FHW-Appel/MicroMouse-car/README.md

# MicroMouse

Denken Sie daran, dass Sie keine großen Dateien wie Bilder oder PDFs ins Repository hochladen.
