FHW-Appel/MicroMouse-car/STL-Dateien/Motorhalterung.stl

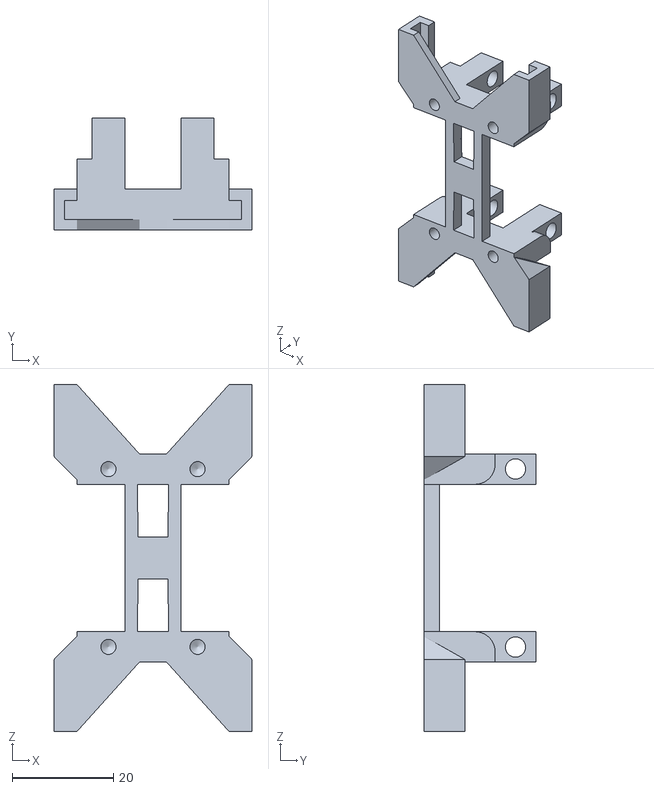
[picture p1: CAD file, 2025-06-27]
STL-Dateien/Motorhalterung.stl
39.0 x 22.0 x 68.5
