FHW-Appel/MicroMouse-car/STL-Dateien/Reifen_Grip.stl

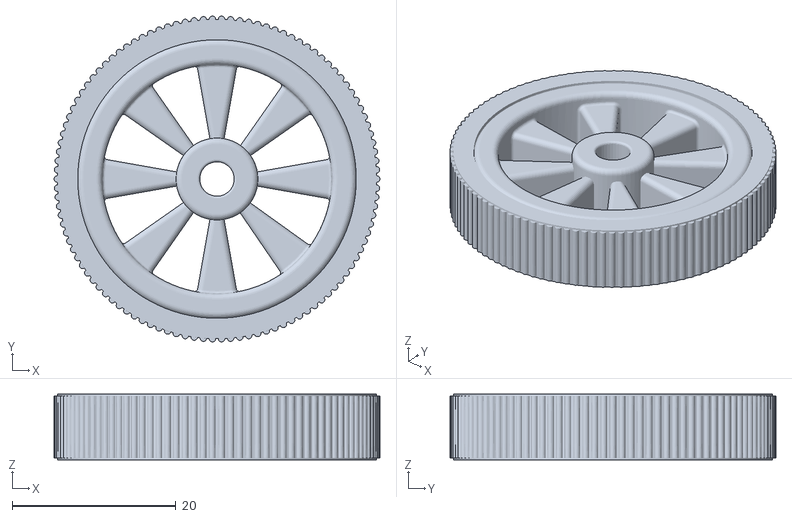
[picture p2: CAD file, 2025-06-27]
STL-Dateien/Reifen_Grip.stl
39.8 x 39.8 x 8.00
