FHW-Appel/MicroMouse-car/STL-Dateien/Schubplatte_Display.stl

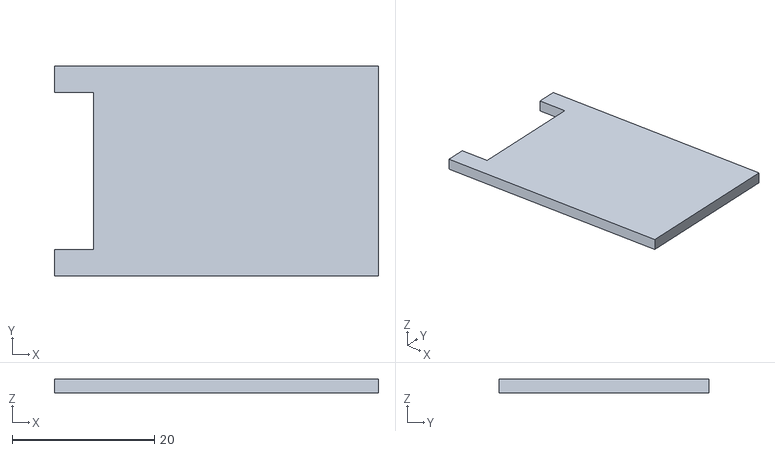
[picture p3: CAD file, 2025-06-27]
STL-Dateien/Schubplatte_Display.stl
45.5 x 29.5 x 2.00
