FHW-Appel/MicroMouse-car/STL-Dateien/Akkuhalterung.stl

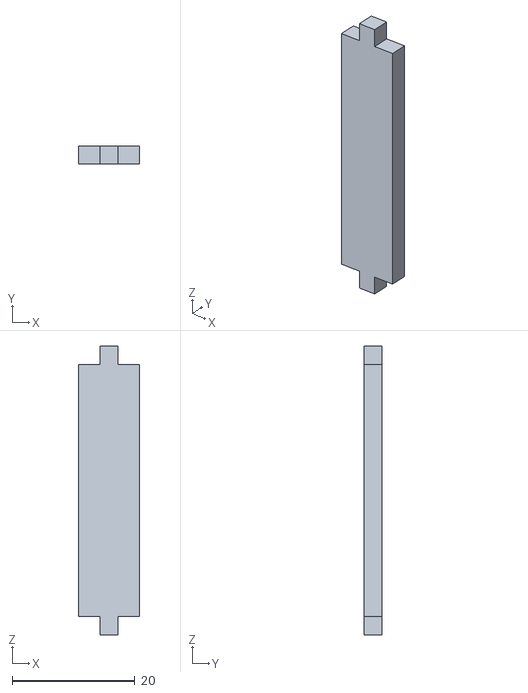
[picture p4: CAD file, 2025-06-27]
STL-Dateien/Akkuhalterung.stl
10.0 x 3.00 x 47.0
