FHW-Appel/MicroMouse-car/STL-Dateien/Sensorhalter_Schleifpunkt.stl

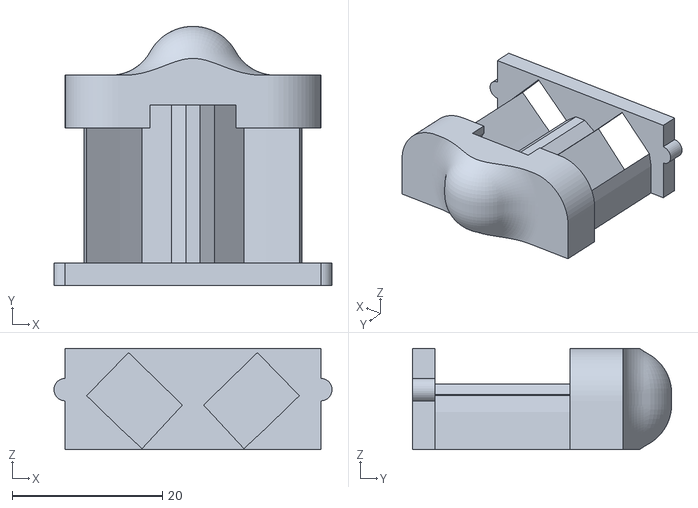
[picture p5: CAD file, 2025-06-27]
STL-Dateien/Sensorhalter_Schleifpunkt.stl
37.0 x 34.5 x 13.5
