FHW-Appel/MicroMouse-car/STL-Dateien/Deckel.stl

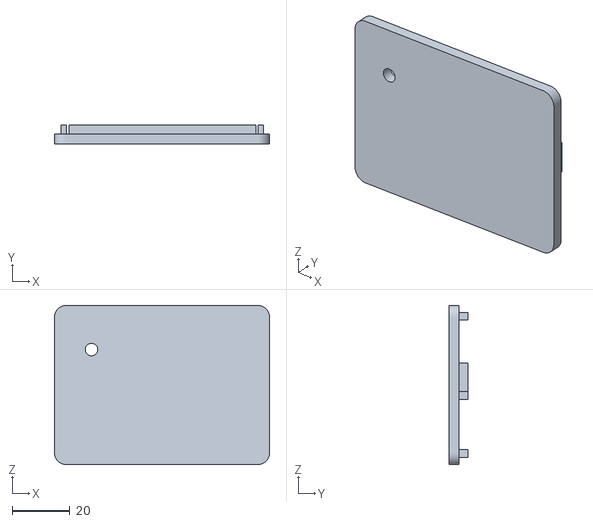
[picture p6: CAD file, 2025-06-27]
STL-Dateien/Deckel.stl
74.6 x 6.50 x 55.2
