FHW-Appel/MicroMouse-car/STL-Dateien/Kaese.stl

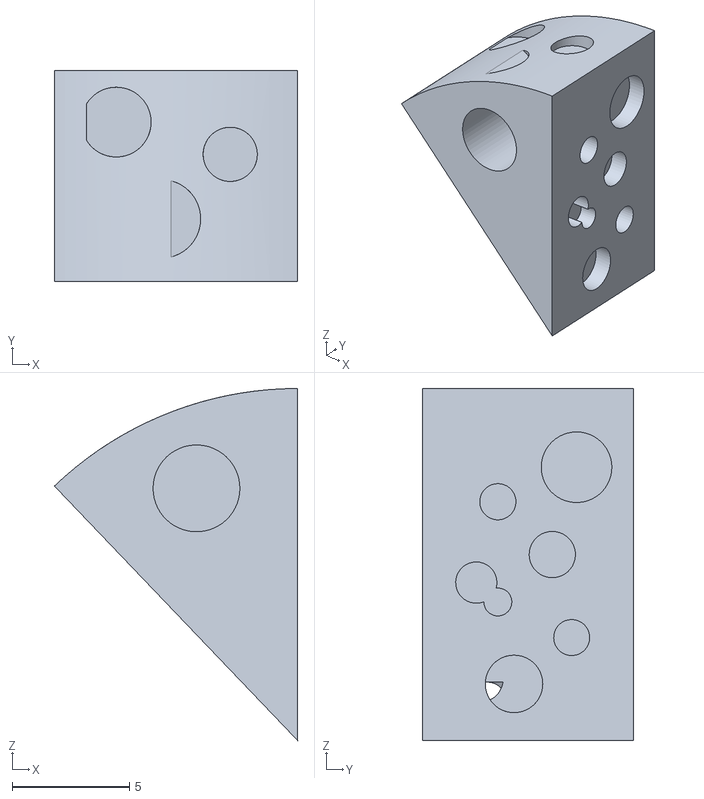
[picture p7: CAD file, 2025-06-27]
STL-Dateien/Kaese.stl
10.4 x 9.00 x 15.0
