FHW-Appel/MicroMouse-car/STL-Dateien/Displaygehäuse.stl

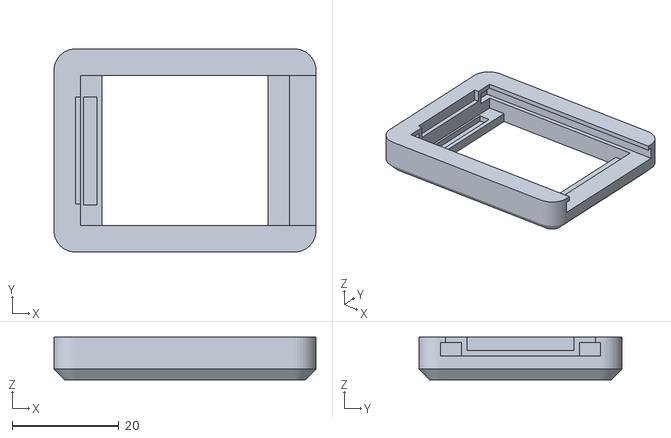
[picture p8: CAD file, 2025-06-27]
STL-Dateien/Displaygehäuse.stl
49.0 x 38.0 x 8.00
