FHW-Appel/MicroMouse-car/(list of files, cad)

Other CAD files:
Fusion-Konstruktionen/Akkuhalterung.f3d
Fusion-Konstruktionen/Deckel.f3d
Fusion-Konstruktionen/Displaygehäuse.f3d
Fusion-Konstruktionen/Kaese.f3d
Fusion-Konstruktionen/Micro Maus Motorhalterung.f3z
Fusion-Konstruktionen/Platinengehäuse.f3d
Fusion-Konstruktionen/Reifen_Grip.f3d
Fusion-Konstruktionen/SchubplatteDisplaygehäuse.f3d
Fusion-Konstruktionen/Sensorhalter_Schleifpunkt.f3d
