FHW-Appel/MicroMouse-car/(threads)

Thread 1 (2025-04-04):

Formfaktor ermitteln und festlegen

Nikoru112, 2025-04-04:
Nach den gängigen Richtlinien wird die gängige Größe festgelegt und mit den anderen Gruppen abgesprochen.

Nikoru112, 2025-05-09:
**Aktueller Stand Formfaktor 09.05.2025**
- Maximale **Breite** der Maus: **5cm** (Festgelegt, damit die Maus diagonal durch das Maze fahren kann)
- Maximale **Länge** der Maus: **7cm** (9cm(Breite Maze)- 7cm = 1cm Platz auf jeder Seite zum wenden)
(Max. Länge der Platine 6cm. Daher kann ggf. die Länge noch etwas eingekürzt werden.)
- Maximale **Höhe**: Hierzu gibt es **keine Vorgaben**.

Thread 2 (2025-04-04):

Fahrzeug

Nikoru112, 2025-04-04:
* Formfaktor ermitteln und festlegen
* Kompatibilität zum Shield
* Absprache Motor mit Shield Team
  * Aufnahme für Motoren entwickeln
* Lenktechnik festlegen
* Bumper
* Reifen
* Achsen und Lagen, wenn nicht im Motor enthalten
* Aufnahme Sensoren
* Akku definieren
* Akkuaufnahme
* Repository erstellen

* Design

### Projektstruktur - Fahrzeug:

### Haupt-Issues:
1. Formfaktor festlegen
#1
2. CAD u. Druck des Fahrzeugs
#16  (Inkl. aller Neben-Issues)
3. Design
#14

### Neben-Issues:

**Größe der Platine abstimmen**
#7
- CAD Platinenhalterung #17

**Kennwerte Motoren abstimmen**
#8
- CAD Aufnahme für Motoren designen #9

**Kennwerte der Sensoren abstimmen**
#10
-  CAD Halterungen: Positionierung der Sensoren #11

**Akku festlegen**
#12
- CAD Akku-Halterung #13

**Räder finden und beschaffen**
#15

**Repository erstellen**
#18

Closed 2025-06-27.

Thread 4 (2025-04-05):

Maze

FHW-Appel, 2025-04-05:
* Half size micro mouse Maße raussuchen und als Anforderungen zusammenschreiben
* Verbindungstechnik Schachbrettkästchen entwickeln und testen
* Verbindungstechnik Wände entwickeln und testen
* Wandmodule
* Blindstopfen entwickeln
* Wand zu Wand Verbindungen
* Repository erstellen

Thread 5 (2025-04-05):

Shield

FHW-Appel, 2025-04-05:
* Recherche notwendigen Sensoren
* Recherche notwendigen Motoren
* Visualisierung Gerätezustand
* Debugschnittstelle
* Schnittstelle uC Platine
* Microcontrollerplatine (uC) festlegen
  * nicht älter als drei Jahre
  * STM32L oder U

* Kompatible zum uC, Spannungsversorgung, Montage
* Hot-Swap

Thread 6 (2025-04-05):

Programmierung Abstraktionslayer

FHW-Appel, 2025-04-05:
* Absprache mit Shield Team über Schnittstellen
  * Sensoren
  * Motoren
  * (Speicher)
  * LEDs, etc..
* Implementierung einer Debug-Schnittstelle (UART)
* Abtraktions Layer erstellen
* Support Layer Erstellen
* Repository erstellen
* Test-Cases erstellen
* Tests Automatisieren

Thread 10 (2025-04-06):

Dimensionen der Sensoren erfragen

MiBeFe, 2025-04-06:
**Beschreibung:**
Die Größe und Anzahl der Sensoren wird durch die Shield-Gruppe festgelegt.
Wir überprüfen die Kompatibilität mit der der Gesamtgröße/ des Formfaktors des Fahrzeugs.

**Akzeptanzkriterien:**
- Daten von der Shield-Gruppe erhalten(Größe u. Anzahl Sensoren)
- Sensoren passen in die Maus.
- Klärung der Sensorlage in der Maus

LuiNi31, 2025-05-14:
Sensoren wurden bestellt und sind stand 14.05.2025 angekommen. Die Sensoren entsprechen der gewünschten Größe und sind dementsprechend kompatibel mit der Maus.

FHW-Appel, 2025-05-16:
Warum liegt dieses Issue noch in der Spalte _"In progress"_? Bitte nach _"Review"_ verschieben.

Nikoru112, 2025-05-16:
**To do erledigt Stand 16.05.2025**

Akzeptanzkriterien:
**"Daten von der Shield-Gruppe erhalten(Größe u. Anzahl Sensoren)"**
Sensoren sind , wie oben am 14.05. dokumentiert, bei uns eingetroffen, somit liegt die Größe und Anzahl vor.
"In der Maus werden 2 Sensoren vorne und zwei hinten verbaut.!
**"Sensoren passen in die Maus."**
Mit den Maßen von ca. 10x10x25mm passen die Sensoren in die Maus.
"Klärung der Sensorlage in der Maus"
Jeweils im 45Grad- Winkel nach links und rechts in Fahrtrichtung der Maus. Hinten identisch.

Da alle Akzeptanzkriterien erfüllt wurden, kann dieses Issue geschlossen werden.

Closed 2025-05-17.

Thread 11 (2025-04-06):

Positionierung der Sensoren + passende Aufnahme designen (soll nach möglichkeit zum Thema Maus beitragen)

MiBeFe, 2025-04-06:
Vermutlich einer der folgenden Typen:
- Sonar sensors
- IR distance measuring sensors — sharp IR
- Time of Flight(ToF) sensors
ausgewählt nach:
- Reaktionszeit
- Genauigkeit
- Reichweite
- Größe

Positionierung legt am Ende das Sichtfeld der Maus fest. Vermutlich mindestens 4 Sensoren für gute Navigation benötigt.

Nikoru112, 2025-05-09:
**Aktueller Stand Sensoren Positionierung (09.05.2025)**
- Die Sensoren werden in der zweimotorigen Maus im vorderen Teil, der nicht durch die Motoren(hinten) belegt ist untergebraucht.
- Die  Abstandssensoren werden auf einer Trägerplatte in der vorderen Teil der Micro-Maus geschoben.
- An dieser Trägerplatte befindet sich zusätzlich der "Schleifpunkt".

FHW-Appel, 2025-05-16:
Bitte unter Code auch die f3d Dateien ablegen.

Nikoru112, 2025-05-16:
**Aktueller Stand Sensorhalterung (16.05.2025)**
- Die erste Version der Sensorhalterung wurde erstellt. Sie trägt 2 Sensoren und lässt sich in den vorderen und hinteren Teil der Micro Maus schieben.
- An der Sensorhalterung befindet sich zusätzlich der Schleifpunkt der Maus, damit diese auf 2 rädern fahren kann.
- f3d-Datei der Sensorhalterung wurde hochgeladen.

Thread 12 (2025-04-06):

Mit Shield-Gruppe den Akku Dimensionieren

MiBeFe, 2025-04-06:
**Beschreibung**
Die Größe der Platine wird zusammen mit der Shield-Gruppe fest gelegt. Hierbei wird zusammen eine Akku-Größe gefunden.
Wir überprüfen die Kompatibilität mit der der Gesamtgröße/ des Formfaktors des Fahrzeugs.
Auf diese Basis der Akkugröße wird das Fahrzeug geplant.

Die Spannung wird durch die Shield-Gruppe festgelegt.

**Akzeptanzkriterien:**
- Daten von der Shieldgruppe erhalten
- Akku ist kleiner als die Außenmaße des Fahrzeugs

Vorläufiges Ergebnis:
https://www.conrad.de/de/p/renata-icp501233pa-spezial-akku-prismatisch-kabel-lipo-3-7-v-175-mah-252025.html
Spannung: 3.7V | Kapazität (mAh, Ah): 175mAh oder
https://www.conrad.de/de/p/renata-icp50123ps-03-spezial-akku-prismatisch-kabel-lipo-3-7-v-130-mah-252021.html
Spannung: 3.7V | Kapazität (mAh, Ah): 130mAh

- Erstmal werden wir den Akku mit der höheren Kapazität (aber auch leicht größeren Maßen) ausprobieren.
- Durch Reihenschaltung von zwei besagten Akkus erhalten wir: Spannung 7,4V | Kapazität 175mAh.
- Maße des Akkus passen zwischen die Motoren.
- Spannungsvorgaben des Shieldteams sind erfüllt.
- Preislich im Rahmen

MiBeFe, 2025-05-11:
Auswahl eines Akkus vorläufig Abgeschlossen. Der 175mAh Akku erfüllt unsere Ansprüche am Besten:
- Durch Reihenschaltung kommen wir auf die Vorgabe des Shield-Teams.
- Die minimal größeren Maße sind in Anbetracht der verbesserten Kapazität akzeptabel.
Es folgen eventuell noch Änderung aufgrund von Anpassungen an der Form des Fahrzeugs bzw. der Platine.
Bestellung der Akkus ist angefragt.

Closed 2025-05-11.

Thread 13 (2025-04-06):

CAD Akku-Halterung

MiBeFe, 2025-04-06:
Die Maus verfügt über einen geeigneten Ort zur Unterbringung der Akkus.

**Akzeptanzkriterien**
- Die Akkus passen in die Maus.
- Akkus sind bei bedarf entnehmbar.
- Akkus haben einen fest definierten Platz.
- Der Schwerpunkt der Maus wurde beachtet

Nikoru112, 2025-05-03:
**Erstellung von Akkus in Fusion**
Die Akkus wurde in Fusion den Abmessungen entsprechenden nachgebaut
2 Verschiedene Akkuversionen haben wir jeweils 2x ausgedruckt.

LuiNi31, 2025-05-14:
2 Akkus (Renata ICP581323PA Spezial-Akku Prismatisch Kabel LiPo 3.7 V 140 mAh) wurden bestellt und sind seit dem 14.05.2025 Vorort. Die Akkus entsprechen unseren Vorstellungen und sind größentechnisch kompatibel mit der Maus. Es werden stand jetzt 2 Akkus in Reihe geschaltet. Die Akkus sind kompatibel mit den 1,7V Motoren.

Nikoru112, 2025-05-16:
**Aktueller Status 16.05.2025 Akkus**

In der Aktuellen Micro Maus Version werden die Akkus in der Maus zwischen den Motoren untergebracht.
Aktuell ist in Klärung, ob 2 oder 4 Akkus verwendet werden.

MiBeFe, 2025-06-06:
Wir haben uns nochmal für andere Akkus entschieden, da diese mehr Kapazität mitbringen und nahezu perfekt in die vorgesehene Aussparung passen. Es handelt sich um: 3.7V 200mAh Akku 502025 Lithium-Polymer-Ionen-Lithium-Ionen-Li-Po-Akku mit 2P-PH-Anschluss mit 2.0 mm Rastermaß bei https://www.amazon.de/dp/B0CSS49XFG?ref=ppx_yo2ov_dt_b_fed_asin_title.
Zwei Stück sind bestellt worden und seit dem 06.06.25 vor Ort und montiert.

MiBeFe, 2025-06-27:
Die Akkuhalterung ist nun endgültig fertiggestellt und schließt die Aussparung zwischen den Motoren vollständig ab. Dadurch sind die Akkus stabil sowie sicher verankert und dennoch jederzeit einfach entnehmbar. Die Halterung selbst wird zwischen den Sensoraufnahmen eingeschoben. Um die Akkus zu entnehmen, muss lediglich eine Sensorhalterung gelöst werden.

Closed 2025-06-27.

Thread 14 (2025-04-06):

CAD: Design (Mausartig) umsetzen

MiBeFe, 2025-04-06:
**Beschreibung:**
Design des Fahrzeug an die Ähnlichkeit einer Maus.
Ggf. Graues kantiges design wie ein Cybertruck im Maus design.

**Akzeptanzkriterien:**
- Eine 3. Person erkennt, das es sich bei dem Fahrzeug um eine Maus handelt.
- Weiteres Erfolgt je nach verfügbarer Zeit.

**Möglichkeiten:**
- Fell
- kleine Ohren
- Augen mit Sensoren oder LED's nachahmen
- Schwanz (gehört wenn angehängt womöglich nicht zum Fahrzeug selbst und dürfte somit Kontakt zu Wänden haben)
- Räder genauer Felgen mit Füßchen bekleben/bemalen (wenn seitlich genug Platz übrig)
- kleiner Lautsprecher für mausartige Geräusche oder so

Closed 2025-06-27.

Thread 15 (2025-04-06):

Räder finden u. beschaffen (Rädermaße u. Bereifung)

MiBeFe, 2025-04-06:
**Beschreibung:**

Findung der passenden Räder für die Maus. Dabei müssen diese zum Motor passen und dem in #8 ermittelten Motor zusammenpassen.

Abstand zum Boden und Ziel-Untergrund muss beachtet werden.
Haftung sollte möglichst groß sein ohne Lenken oder Motorleistung zu beeinträchtigen.

Berechnung der Geschwindigkeit in Verbindung mit den Ausgewählten Motoren, sodass die Maus nicht zu langsam und nicht zu schnell ist.

**Akzeptanzkriterien:**
- Die Maus hat Räder.
- Die Räder können die Maus bewegen.
- Die Räder passen zum Motor
  - Ein Durchdrehen der Reifen auf der Achse kann bei bekannter maximaler Beschleunigung ausgeschlossen werden.
- Das Fahrzeug hat keine Bauteile im Bereich der Räder(Ggf. in Fusion anpassen)
- Räder drehen nicht durch.
  - Der Traktionskoeffizient ist bekannt.
  - Aus dem Traktionskoeffizient kann die maximale Beschleunigung errechnet werden.

ChrErn18, 2025-04-23:
## Entscheidung zur Rädern: Kauf statt Eigenkonstruktion

### Hintergrund:
Ursprünglich war vorgesehen, die Reifen für das Micro-Kart selbst zu entwerfen und im 3D-Druckverfahren herzustellen. Diese Strategie wurde auf Basis folgender Überlegungen verworfen:

- Zeit- und Ressourcenaufwand für Konstruktion, Testdrucke und Materialauswahl wäre aktuell zu hoch (die frühzeitige Erstellung eines Prototyps wird priorisiert)
- Es gibt auf dem Markt passende Reifenlösungen, die unsere Anforderungen bereits erfüllen könnten

### Neue Vorgehensweise:
- Recherche nach **geeigneten käuflich zu erwerbenden Reifen**, die folgende Kriterien erfüllen:
  - **Sehr hoher Grip**
  - **Breite unter 5 mm**
  - **Kompatibilität mit dem Motor** (siehe Issue #8)
  - Passend für unseren Ziel-Untergrund
  - Erlauben ausreichenden Bodenabstand
- **Beschaffung der gewählten Reifen**

### Zukünftige Option:
Sollten im weiteren Projektverlauf Kapazitäten frei werden, bleibt die Option offen, ein eigenes Reifenmodell zu konstruieren. Diese Alternative wird aktuell **nicht weiterverfolgt**, soll aber bei Bedarf reaktiviert werden können.

ChrErn18, 2025-04-25:
## Entscheidung zurück zur Eigenkonstruktion

### Hintergrund:
Nach längerer Recherche wurden leider keine passenden Reifen/ Räder gefunden, die allen Anforderungen entsprechen (Breite >5mm, Durchmesser > 30mm, Kompatibilität 4mm Achse).

### Neue Vorgehensweise:
- Reifen selbst in einer CAD Software erstellen und mit dem 3D-Drucker ausdrucken
- es sollen weiterhin die folgenden Kriterien erfüllt werden:
  - **Sehr hoher Grip**
  - **Breite unter 5 mm**
  - **Durchmesser unter 30mm**
  - **Kompatibel mit 4mm Wellen des Motors**
  - **Kompatibilität mit dem Motor** (siehe Issue #8)
  - Passend für unseren Ziel-Untergrund
  - Erlauben ausreichenden Bodenabstand

FHW-Appel, 2025-04-30:
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

Ich habe Filament TPU 95A beschafft:
https://www.3dmensionals.de/ultimaker-tpu-95a-premium-filament-4610#attr=42626,42625,42637,42624,42619,42620,42623,42622,42631,42632,42636
Mit diesem Filament können Sie Gummiartige Reifen drucken.

ChrErn18, 2025-04-30:
> [@ChrErn18](https://github.com/ChrErn18) Ich habe Filament TPU 95A beschafft: https://www.3dmensionals.de/ultimaker-tpu-95a-premium-filament-4610#attr=42626,42625,42637,42624,42619,42620,42623,42622,42631,42632,42636 Mit diesem Filament können Sie Gummiartige Reifen drucken.

Vielen Dank, das hilft uns sehr weiter!

ChrErn18, 2025-05-09:
## Reifenentwicklung

Die den Kriterien entsprechenden Reifen wurden in Fusion 360 modelliert und anschließend mittels 3D-Druck gefertigt. Das gedruckte Modell wurde begutachtet und basierend auf den Beobachtungen angepasst. Aktuell befinden wir uns bei der dritten Version des Reifens, welche ebenfalls ausgedruckt wurde und als Grundlage für die weitere Bearbeitung dient.

LuiNi31, 2025-05-14:
Die Reifen mit dem Durchmesser von 31mm entsprach nicht unseren gewünschten Vorgaben, daher haben wir die Reifen auf einen Durchmesser von 40mm vergrößert und diese passten sehr gut. Nur waren die Reifen, wenn man von oben guckt nicht plan mit dem Motor. Da wir nur zum Boden hin einen Überstand brauchen, verkleinern wir die Reifen auf 39 mm. Als nächstes drucken wir die Reifen mit einem Durchmesser von 39 und wenn der zufriedenstellend ist, werden wir die finalen Reifen mit zwei verschiedenen Filamenten drucken. Dementsprechend bestehen die Reifen im finalen Zustand zu 95% aus PLA und 5% aus TPU. Die Riffelung der Reifen, also der Teil der Bodenkontakt hat besteht aus TPU.

ChrErn18, 2025-05-14:
Zur Bestimmung des Traktionskoeffizienten und der maximalen Beschleunigung, ist in der kommenden Stunde ein Versuch geplant. Voraussetzung ist, das wir bis dahin einen Reife drucken, der mit zwei Filamenten gedruckt wurde (PLA und TPU).
Genauere Beschreibung des Testaufbaus, der Durchführung und der entsprechenden Ergebnisse flogen, sobald der Versuch durchgeführt wird.

FHW-Appel, 2025-05-16:
Bitte Ihren aktuellen Druck als f3d Dateien ablegen und in diesem Issue den aktuellen Entwicklungsstand dokumentieren.

ChrErn18, 2025-05-16:
## Aktueller Entwicklungsstand (16.05.2025)

Es wurde ein angepasstes Modell des Reifens erstellt, welches aus zwei Bestandteilen besteht. Einer Felge aus PLA und einem Reifen mit Profil aus TPU. Es war geplant die beiden Komponenten mit den beiden unterschiedlichen Filamenten in einem Stück mit dem 3D-Drucker auszudrucken. Leider kam es zu mehren Fehlversuchen, ausgelöst durch das TPU Filament. Wir haben uns daher entscheiden die beiden Bestandteile einzeln Auszudrucken. Dies klappte dann auch zum Glück, sodass wir am Ende der Stunde vom 16.05.2025 einen Reifen hatten, der aus zwei Komponenten bestand. Die bessere Haftung machte sich im Vergleich zur Vorgänger-Version (nur PLA) des Reifen, auf einem Boden-Element des Maze-Teams, direkt bemerkbar.

### Weiteres vorgehen, bis zur nächsten Stunde:

Das Modell wird erneut etwas angepasst. Das Loch für die Achse des Motors, in der Felge, wird etwas (0,1mm) verkleinert. Reifen und Felge werden mit Nut- und Feder versehen, um zu verhindern, dass der Reifen von der Felge rutschen könnte. Die neuen Modelle werden ausgedruckt, sodass sie für die nächste Stunde bereit stehen.

### Plan für die nächste Stunde
Mit den fertigen Reifen, soll nun im Rahmen eines kleinen Experiments der Traktionskoeffizient bestimmt werden, sodass auf die maximale Geschwindigkeit geschlossen werden kann.

ChrErn18, 2025-06-06:
### Bestimmung des Traktionskoeffizienten und der maximalen Beschleunigung

Im Rahmen unseres Projekts haben wir eigene Reifen für die MicroMouse entworfen und mittels 3D-Druck hergestellt. Die Räder bestehen aus:

- **Felge**: PLA
- **Reifen**: TPU 95A, als abziehbarer Gummireifen

Ziel des Tests war es, den **Haftreibungskoeffizienten (μ)** zu bestimmen, um daraus die **maximale Beschleunigung** berechnen zu können.

---

### Testaufbau

- **Untergrund**: Flache Platte aus PLA (identisch zum späteren Untergrunde im Maze)
- **Methode**: Die Platte wurde schräg gestellt, bis das Fahrzeug gerade **nicht** mehr zu rutschen begann.
- **Ermittelter Neigungswinkel**: **13°**

---

### Ergebnis: Haftreibungskoeffizient

Der Haftreibungskoeffizient ergibt sich aus dem Tangens des Neigungswinkels:

μ = tan(α) = tan(13°) ≈ 0,23

Das bedeutet: Unter den getesteten Bedingungen (Reifen + Untergrund) kann das Fahrzeug etwa **23 % der Normalkraft als maximale Haftkraft** nutzen.

**Zum Vergleich:**

| Materialpaarung               | μ       |
|------------------------------|---------|
| Gummi auf trockenem Asphalt  | 0,8–1,0 |
| Gummi auf Stahl (trocken)    | 0,4–0,6 |
| **Unser Ergebnis (TPU auf PLA)** | **0,23**   |

---

### Maximale Beschleunigung

Die maximale Beschleunigung ohne Durchdrehen der Reifen ergibt sich aus:

a_max = μ * g = 0,23 * 9,81 ≈ 2,26 m/s²

---

### Anmerkung

Die Ergebnisse gelten spezifisch für die Kombination:

- TPU-95A Reifen (3D-gedruckt)
- PLA-Untergrundplatte
- Trocken und sauber

FHW-Appel, 2025-06-07:
Super, genauso habe ich mir das vorgestellt. @ChrErn18 Es wäre noch super, wenn Sie einen Wikieintrag für die Traktion erstellen würden in der die maximale Beschleunigung des Fahrzeuges dokumentiert wird.

Closed 2025-06-07.

Thread 16 (2025-04-06):

Achse/Gearbox wenn benötigt designen

MiBeFe, 2025-04-06:
Wenn nicht bereits ausreichend im Motor integriert

Nikoru112, 2025-04-23:
Damit man sich die Größe der Micro Maus besser vorstellen kann und zur Planung der weiteren Bauteile haben wir einen 1. Prototyp des Fahrzeuges in Fusion konstruiert und ausgedruckt.

Thread 7 (2025-04-06):

Größe der Platine besprechen

MiBeFe, 2025-04-06:
**Beschreibung**
Die Größe der Platine wird zusammen mit der Shield-Gruppe festgelegt. Hierbei gibt die Shield Gruppe die Platinen Größe vor.
Wir überprüfen die Kompatibilität mit der der Gesamtgröße/ des Formfaktors des Fahrzeugs.
Auf Basis der Platinengröße wird das Fahrzeug geplant.

**Akzeptanzkriterien:**
- Daten von der Shieldgruppe erhalten
- Platine ist kleiner als die Außenmaße des Fahrzeugs
- Das Fahrzeug hat einen auf die Platine abgestimmten Platinenhalter.

Closed 2025-04-23.

Thread 8 (2025-04-06):

Kennwerte der Motoren erfragen/festlegen

MiBeFe, 2025-04-06:
1. Spannung bzw. Leistungsaufnahme zur Dimensionierung des Akkus
2. Maße
3. Drehmoment (wenn zu schwach vielleicht Übersetzen?)

FHW-Appel, 2025-04-25:
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

Zu jedem Kriterium muss angegeben werden, ob das Kriterium erfüllt wurde, unter Angabe der Evidenz (Nachweis).

MiBeFe, 2025-06-06:
**Abschluss des Issues**

Ergebnis:
Schrittmotor, NEMA FLAT02, 1,8 °,0,5 A, 1,75 V
https://www.reichelt.de/de/de/shop/produkt/schrittmotor_nema_flat02_1_8_0_5_a_1_75_v-335315
Abmessungen: Breite 40,2 mm Höhe 32,75 mm Tiefe: 9,5 mm + 10 mm Achse

Akzeptanzkriterien:

Spannung bzw. Leistungsaufnahme des Motors passt zur Dimensionierung des Akkus
-> Die Akkus liefern insgesamt eine Spitzenspannung von 7,4V bei einer Kapazität von 200mAh und die Motoren
     (Zwei Stück) brauchen 0,5A Spitzenstrom.
     Somit landen wir bei einer Laufzeit von h = 200mAh / 0,5A + 0,5A = 0,2h = 12 Minuten
     Dies entspricht einer Laufzeit unter idealen Bedingung weshalb Werte in der Realität abweichen werden.

Der Motor passt in die Micro Maus und ist nicht über oder unterdimensioniert
-> Bei unserem Design bilden Motor bzw. Motorhalterung das Herzstück der Mouse und ist somit millimetergenau
     eingepasst.

FHW-Appel, 2025-06-07:
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

Kapazität und maximale Leistungsabgabe am Akku ist nicht das Gleiche. Wenn möglich bitte noch ermitteln, wie groß die maximale Leistungsabgabe am Akku ist. Sollte der Akku weniger Leistung bereitstellen, als die Akkus abgeben können, so ist dies eine neue Anforderung an das Softwareteam die Leistungsaufnahme am Motor zu begrenzen.

MiBeFe, 2025-06-20:
### Maximale Leistungsabgabe bei der Spannungstransformation

Wir sollten keine Probleme bei der maximalen Leistungsabgabe bekommen, da wir von 7,4 V auf 1,75 V transformieren.

Beispielsrechnung:
```math
P = 7,4 \, \mathrm{V} \cdot 0,4 \, \mathrm{A} = 2,96 \,  \mathrm{W}
```

```math
I_\mathrm{max} = \frac{P}{U_2}   = \frac{2,96 W}{1,75 V}  \approx 1,69 A

```

Da der Motor maximal 0,5 A benötigt, sollten wir sogar noch Reserven haben.

Thread 9 (2025-04-06):

Aufnamen für Motoren designen

MiBeFe, 2025-04-06:

Nikoru112, 2025-05-07:
**Aktueller Stand Motorenhalterung (07.05.2025)**

- Eine Motorentesthalterung in Micromausgröße haben wir konstruiert und ausgedruckt.
- Der 3D-gedruckte Motor passt problemlos in die Halterung.
- Aktuelles Problem: Aufgrund der aktuellen Motorenbreite von 40mm ist das Fahrzeug aktuell 82mm lang(2x 40mm + 2mm)

Nikoru112, 2025-05-09:
**Aktueller Stand Motorhalterung (09.05.2025)**

- Um die Länge des Fahrzeugs zu minimieren haben wir uns entschieden, die Micromaus zunächst nur mit 2 Motoren auszustatten.
- Anstatt der Beiden vorderen Reifen verwenden wir eine "Schleifplatte".(Die Schleifplatte wird ein Bauteil inkl. Halterung für die Sensoren sein.)
- Der im vorderen Teil der Maus gewonnene Platz der Maus können wir für die neuen Sensoren verwenden.

FHW-Appel, 2025-05-16:
Bitte unter Code auch die f3d Dateien ablegen.

Nikoru112, 2025-05-16:
**Aktueller Stand Motorhalterung 16.05.2025**
- Die neue Motorhalterung wie am 09.05. beschrieben wurde in Fusion erstellt.
- Die Motorenhalterung ist von vorne und hinten gleich gestaltet, sodass Sensoren von beiden Seiten in die Maus geschoben werden können.
- Neuerdings werden die Motoren durch eine 25mm M3 Schraube fixiert.
- Die f3d-Datei wurde im Repository abgelegt.

Thread 17 (2025-04-09):

CAD Platinenhalterung

Nikoru112, 2025-04-09:
**Beschreibung:**

Aufgrund der in #7 ermittelten Platinengröße gestalten wir eine passende Platinenhalterung in der Maus.(Fusion 360)

**Akzeptanzkriterien:**

- Platine passt in die Maus.
- Platine ist ein und ausbaubar.
- Es genügend Platz für alle Kabel an der Platinen Halterung

Nikoru112, 2025-05-03:
1. Platine wurde zur Größeneinschätzung via 3D-Drucker ausgedruckt.

Closed 2025-06-27.

Thread 18 (2025-04-09):

Respository erstellen (Fahrzeug)

Nikoru112, 2025-04-09:
**Beschreibung**
Für die zentrale Verwaltung aller projektbezogenen Dateien und Quellcodes soll ein Repository erstellt werden. Es dient als gemeinsame Arbeitsplattform für das Team, um Änderungen nachverfolgbar zu machen, die Zusammenarbeit zu erleichtern und die Projektstruktur sauber zu halten. Das Repository soll initial eingerichtet und strukturiert werden.

**Akzeptanzkriterien:**

- Ein Repository wurde erfolgreich auf GitHub erstellt
- Die grundlegende Ordnerstruktur ist angelegt
- Verknüpfung zu Fusion 360 wurde erstellt
- Zugriffsrechte für alle Teammitglieder sind eingerichtet

Nikoru112, 2025-05-07:
**Aktueller Stand: (07.05.2025)**

- Zugriffsrechte für alle Mitglieder in Fusion sind eingerichtet, sodass alle Mitglieder zusammen im Gruppenordner in Fusion arbeiten können.
- Da in Fusion eine Versionsverwaltung exisitiert, verwenden wir aktuell die Versionsverwaltung über Fusion u. nicht über GitHub
- Zur Dokumentation laden wir die Technischen Zeichnungen im Repository in GitHub hoch.

Nikoru112, 2025-05-09:
**Aktueller Stand Repository 09.05.2025**
- Nach Absprache mit Herrn Appel werden die Fusion-Konstruktionsdateien nach jedem Meilenstein manuell in GitHub hochgeladen.
- Bei jedem Meilenstein wird zudem eine technische Zeichnung im Repository in GitHub hochgeladen.(.f3d)

Nikoru112, 2025-06-18:
**Repository eingerichtet**
- Eine Verknüpfung zu GitHub Desktop wurde eingerichtet, sodass wir die Dateien aus Fusion direkt ins Repository hochladen können.

Somit ist dieses Issue abgeschlossen.

Closed 2025-06-27.

Thread 19 (2025-04-25):

CAD: Display

ChrErn18, 2025-04-25:
Um aktuelle Werte/Zustände der Micro Maus angezeigt zu bekommen soll die Maus über ein Display verfügen.
Dies kann entweder an der Maus selbst sein oder via Kabel extern an die Maus ansteckbar.

**Akzeptanzkriterien**
- Die Maus hat ein Display(Egal ob extern oder intern)
- Das Display hat eine Fassung oder ein Gehäuse

ChrErn18, 2025-04-25:
### Erstellung eines Modells in Fusion

* das Display wurde in Fusion den Abmessungen entsprechenden nachgebaut
*  erstelltes Modell wurde ausgedruckt

LuiNi31, 2025-05-22:
Ein Displaygehäuse wurde angefangen in Fusion 360 zu Konstruieren.

LuiNi31, 2025-06-06:
Das Displaygehäuse wurde schon gedruckt und passt zu dem Display. Jetzt werden noch kleine Änderungen vorgenommen, wie eine Einschubplatte mit einem Durchgang für die Kabel, sodass das Display an Ort und Stelle bleibt. Dementsprechend wird das gesamte Gehäuse noch einmal gedruckt und die Schubplatte auch.

LuiNi31, 2025-06-22:
Das Displaygehäuse ist fertig gestellt und entspricht allen gesetzten Anforderungen.

Closed 2025-06-22.
