FHW-Appel/MicroMouse-car/Technische Zeichnungen/TechnischeZeichnungDisplayplatte.pdf

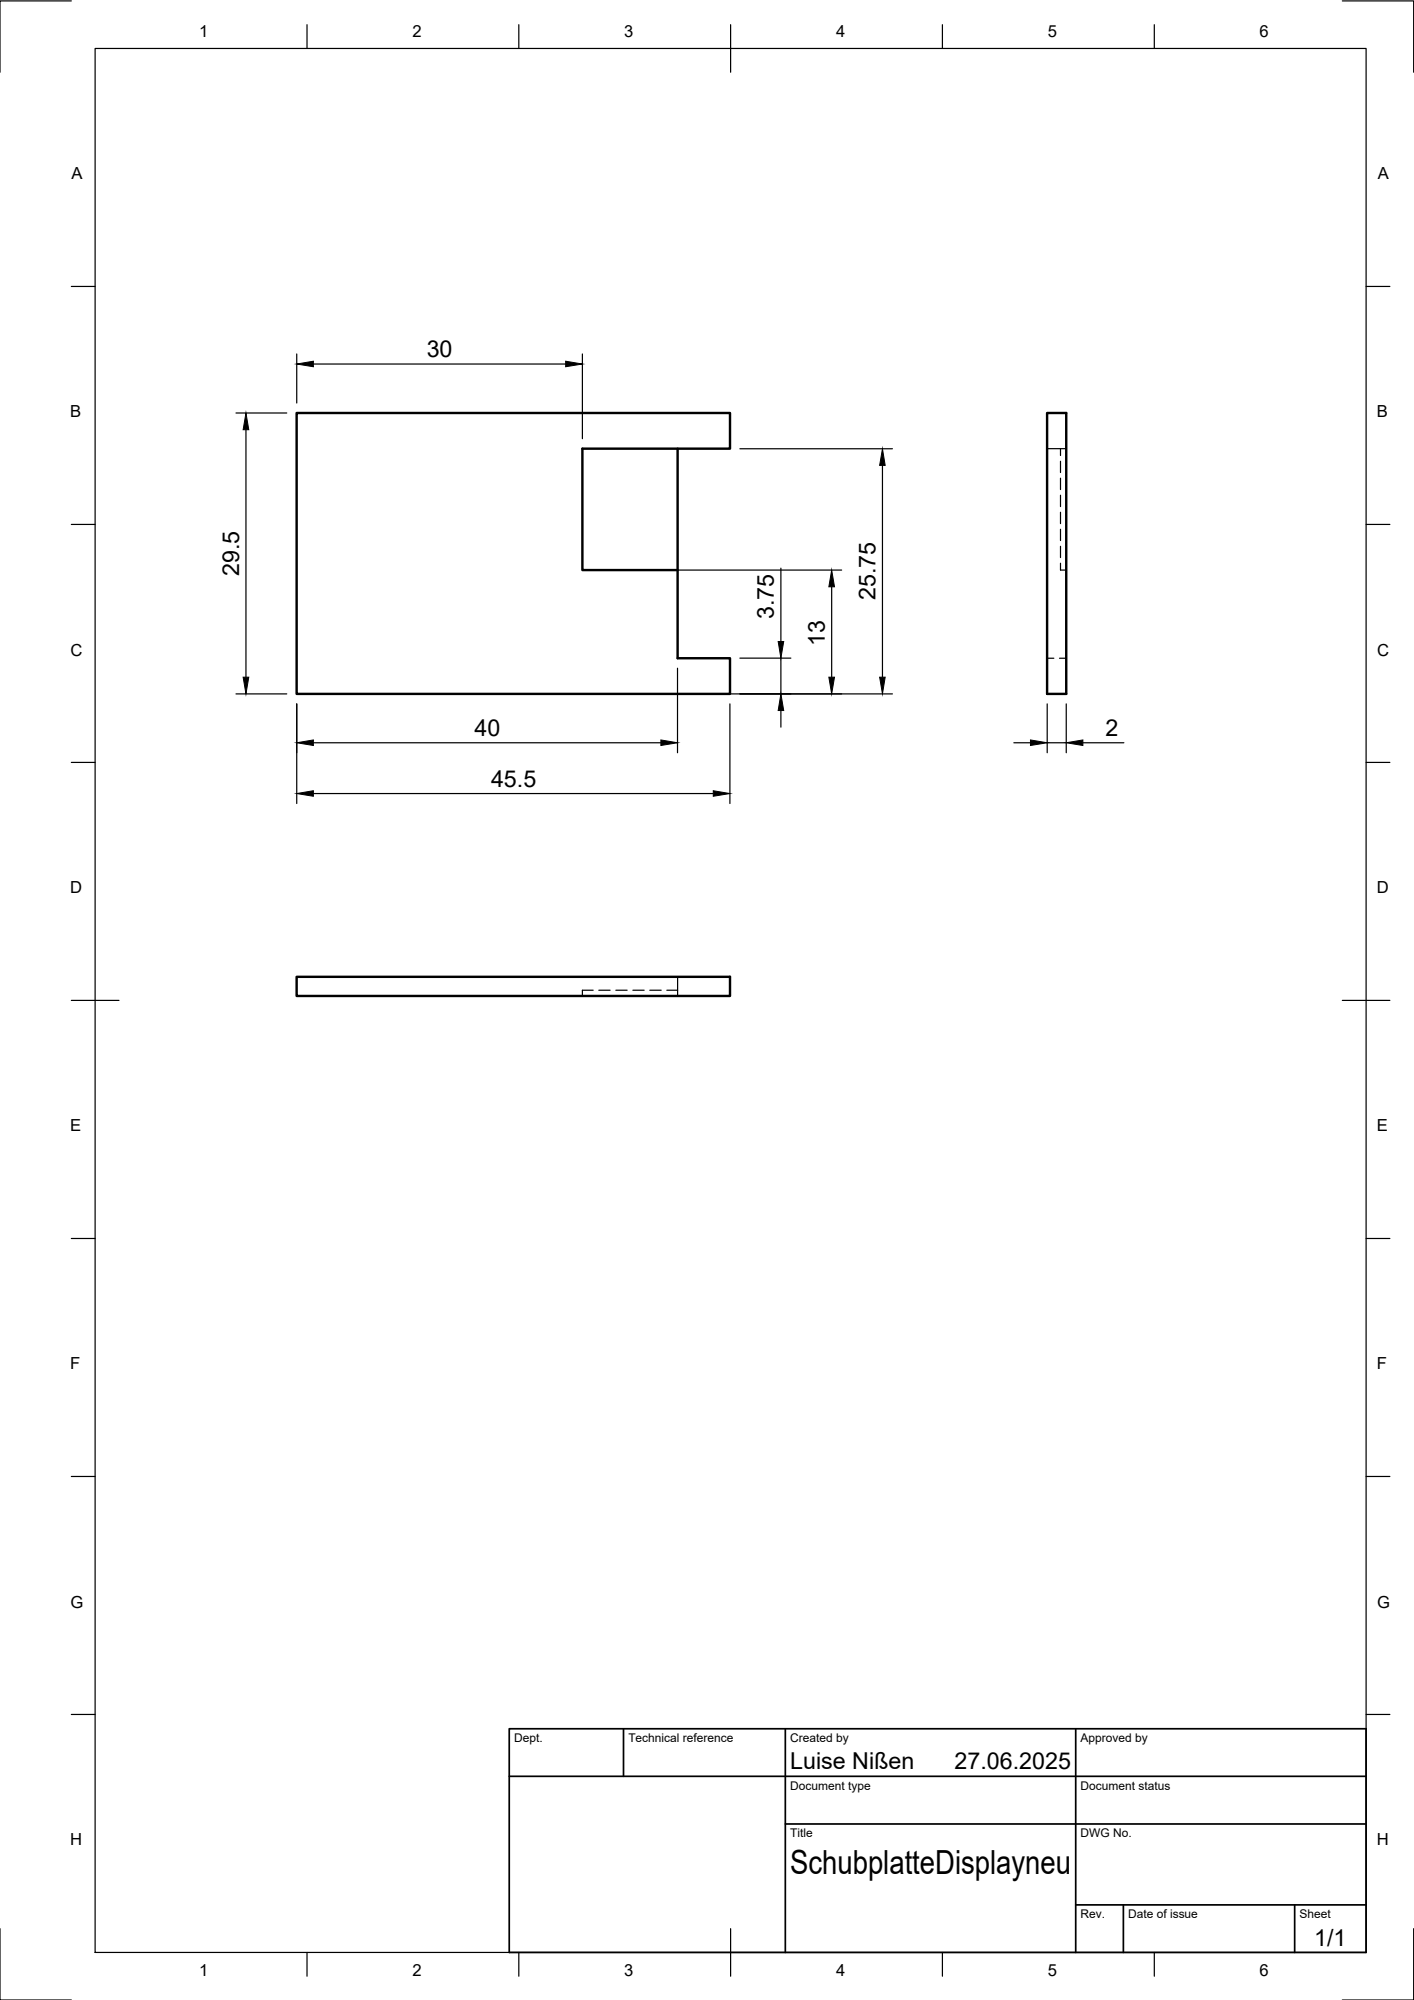
[picture p9: page 1]

Dept. | Technical reference | Created by Luise Nißen 27.06.2025 | Approved by

Document type | Document status

Title SchubplatteDisplayneu | DWG No.

Rev. | Date of issue | Sheet 1/1
