FHW-Appel/MicroMouse-car/Technische Zeichnungen/Technische Zeichnung Motorhalterung.pdf

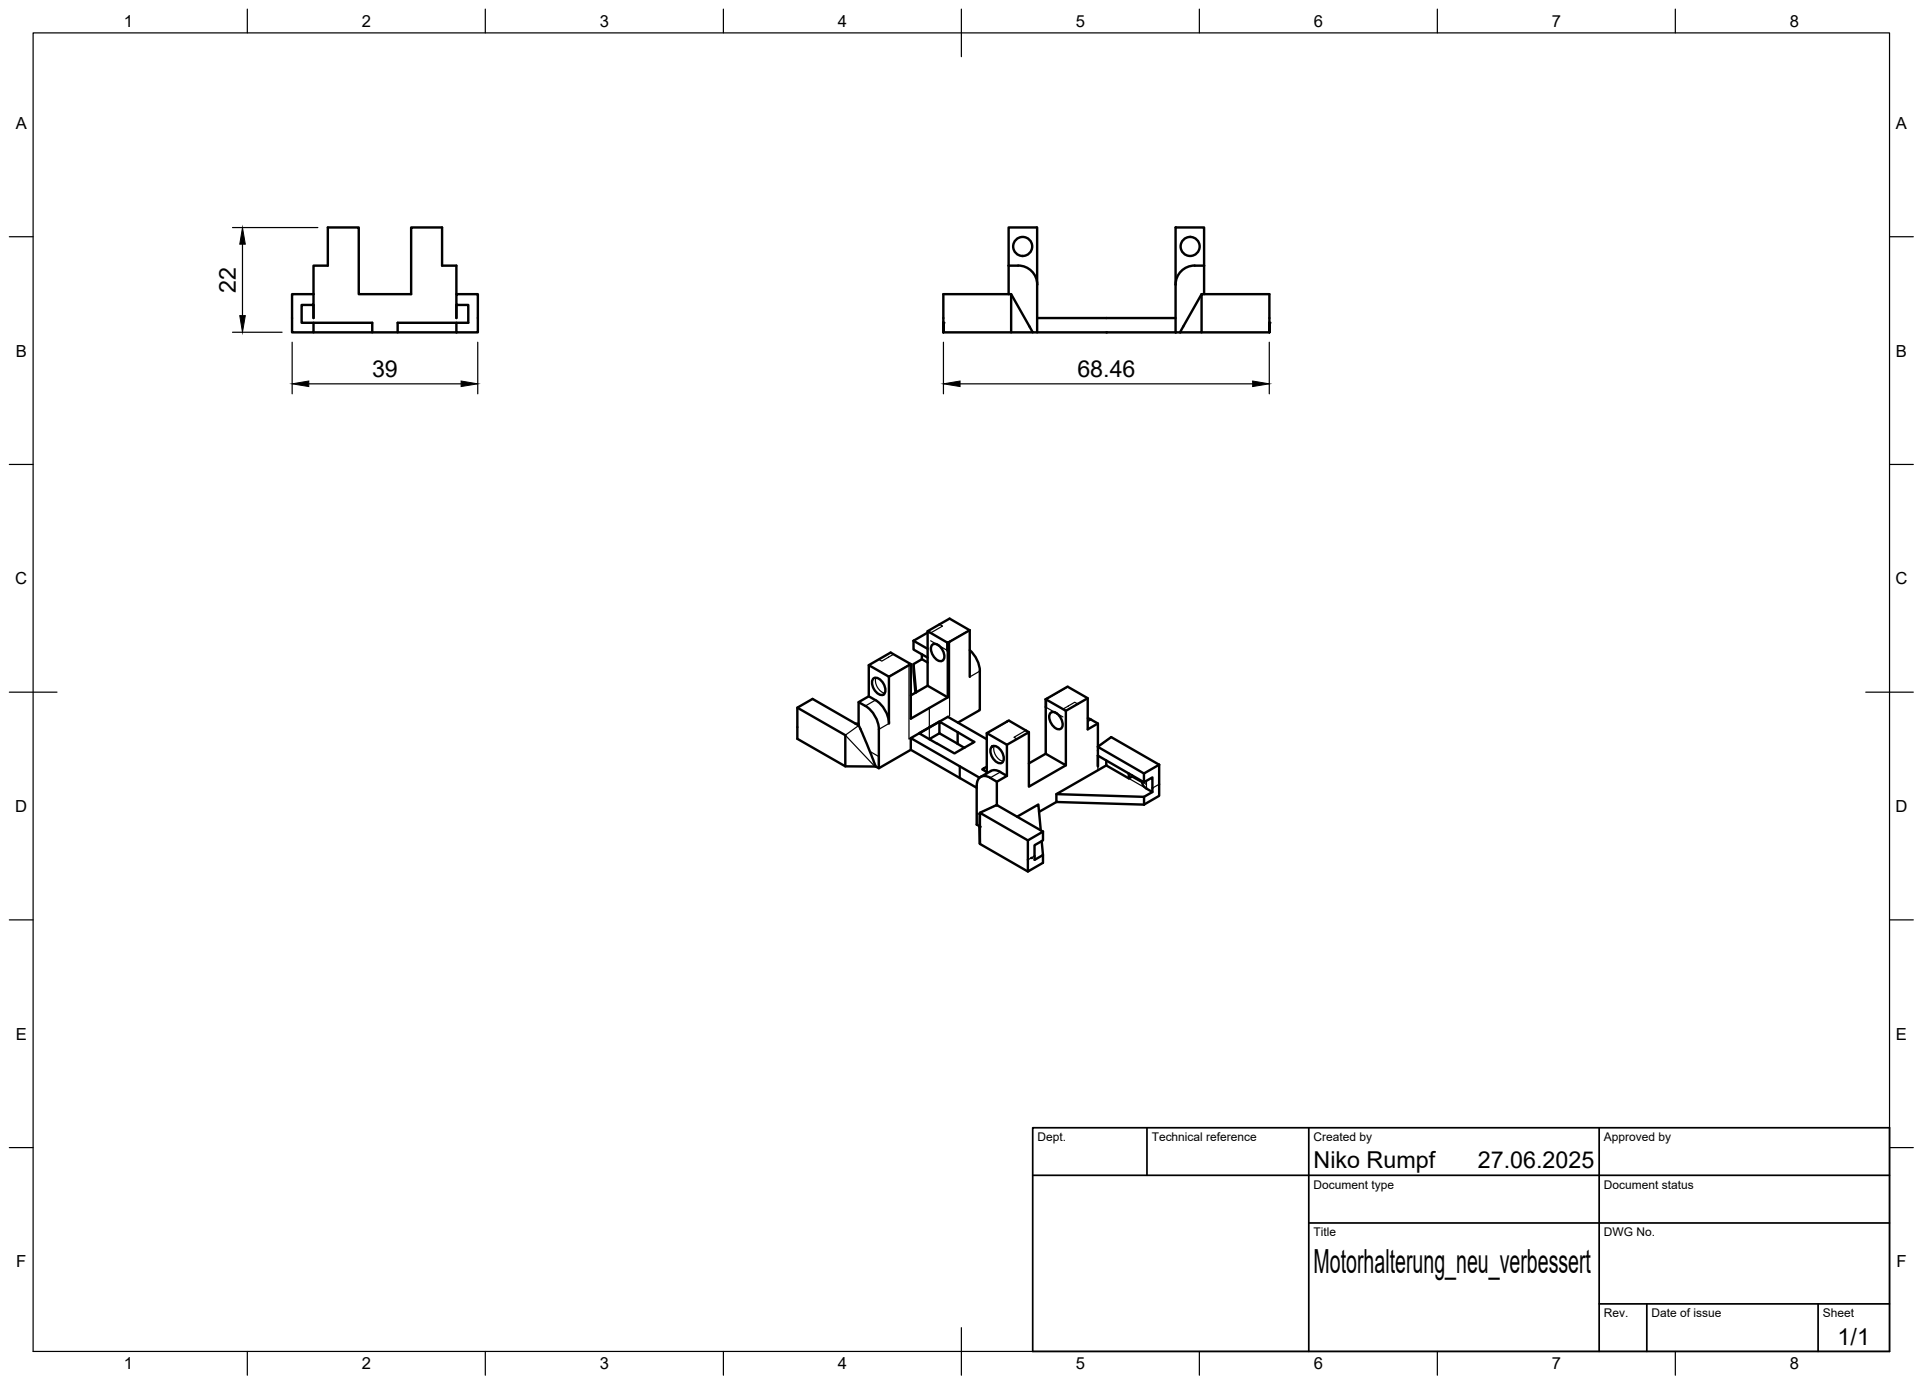
[picture p10: page 1]
Title; DWG No.; Rev.; Date of issue; Sheet

Dept. | Technical reference | Created by Niko Rumpf 27.06.2025 | Approved by

Document type | Document status
