FHW-Appel/MicroMouse-car/Technische Zeichnungen/Technische Zeichnung Sensorhalterung.pdf

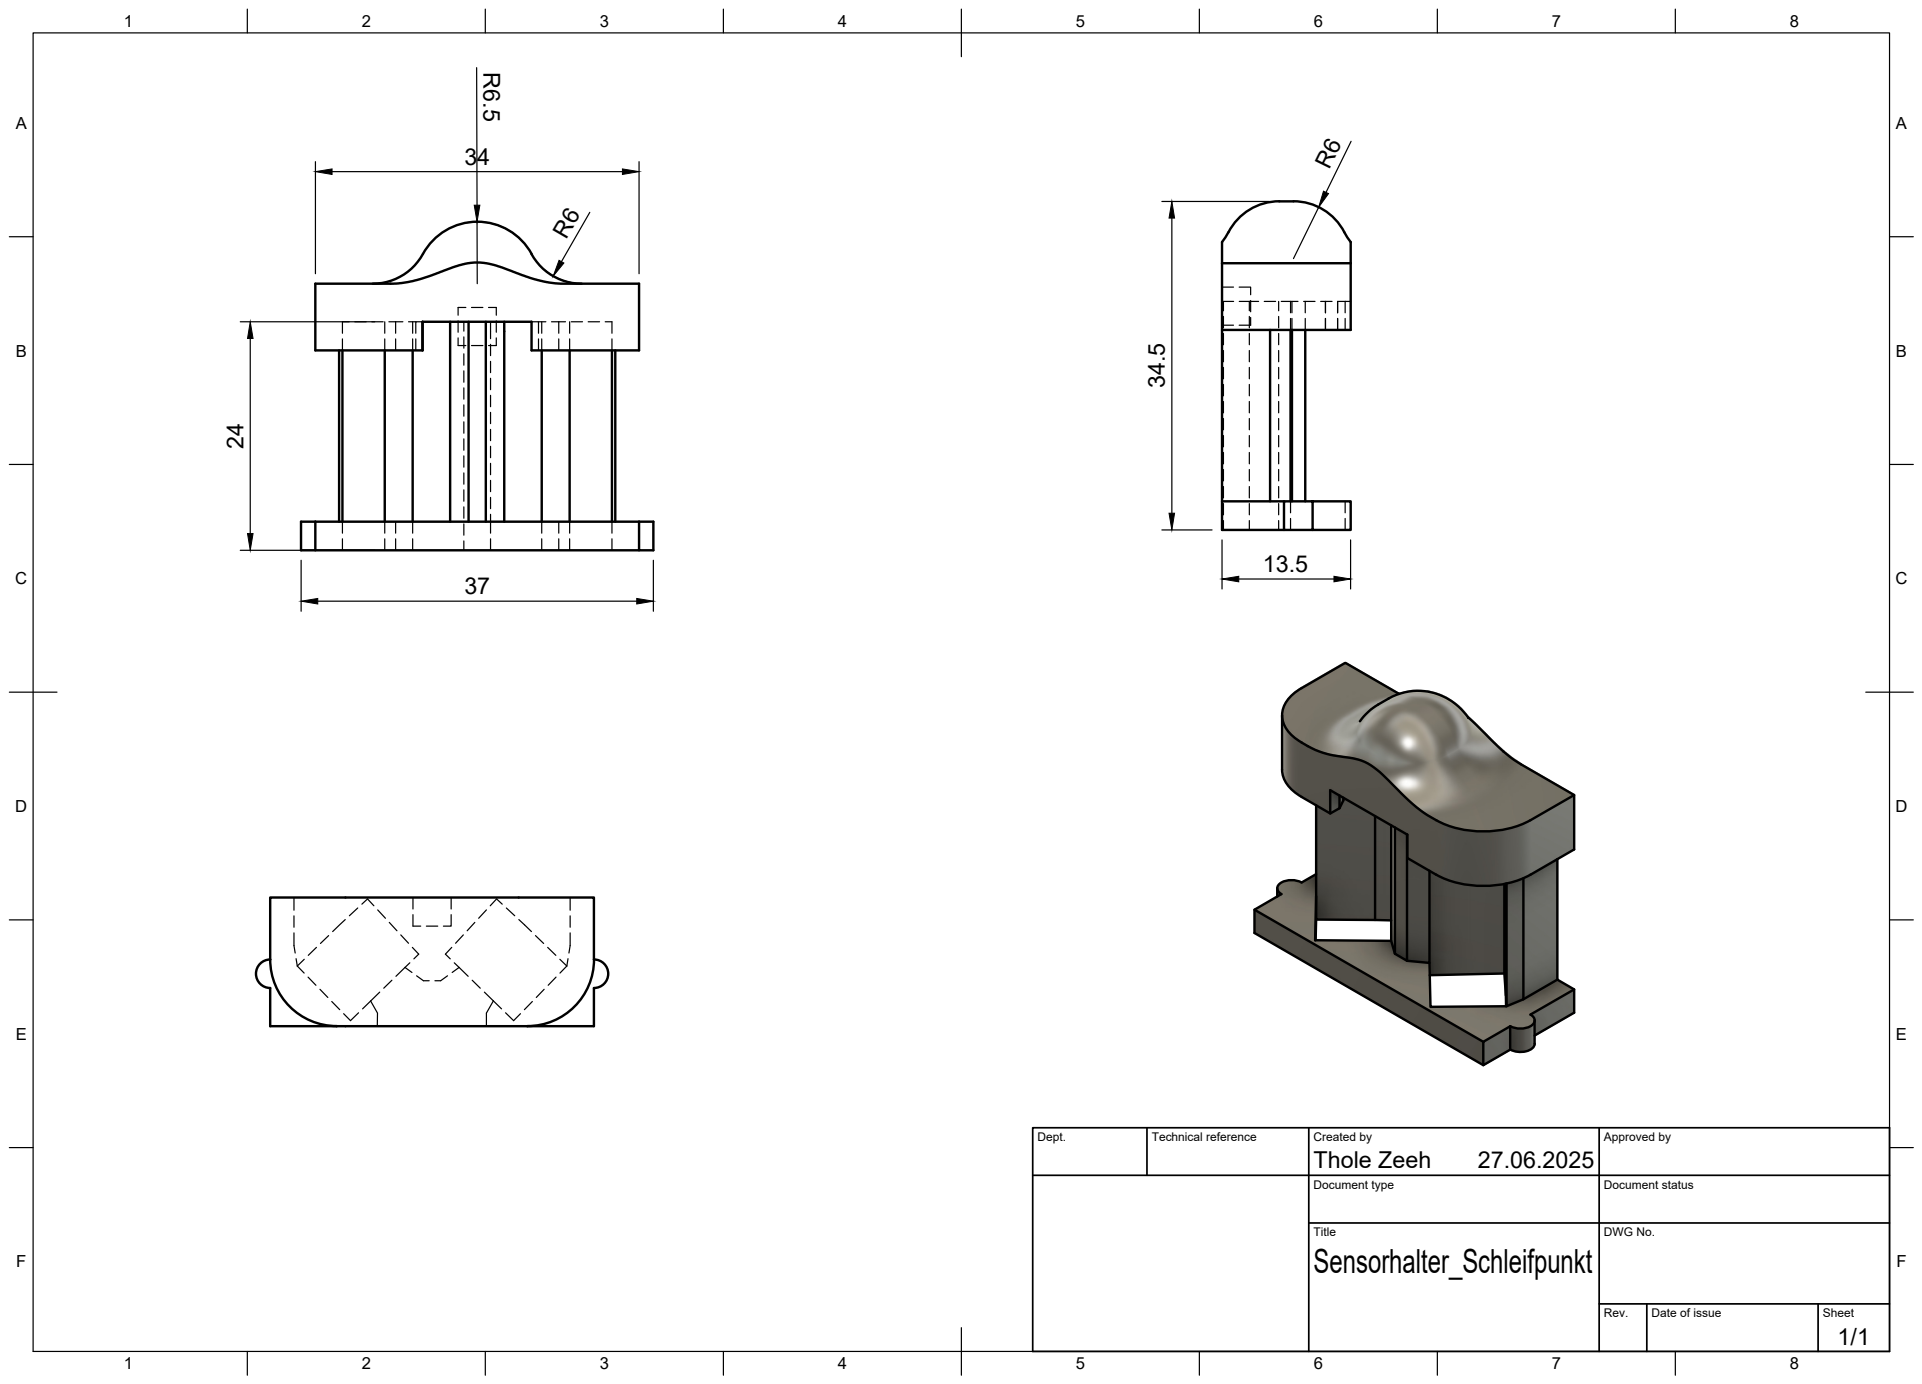
[picture p11: page 1]
Title; DWG No.; Rev.; Date of issue; Sheet

Dept. | Technical reference | Created by Thole Zeeh 27.06.2025 | Approved by

Document type | Document status
