FHW-Appel/MicroMouse-car/Technische Zeichnungen/Technische Zeichnung Motor.pdf

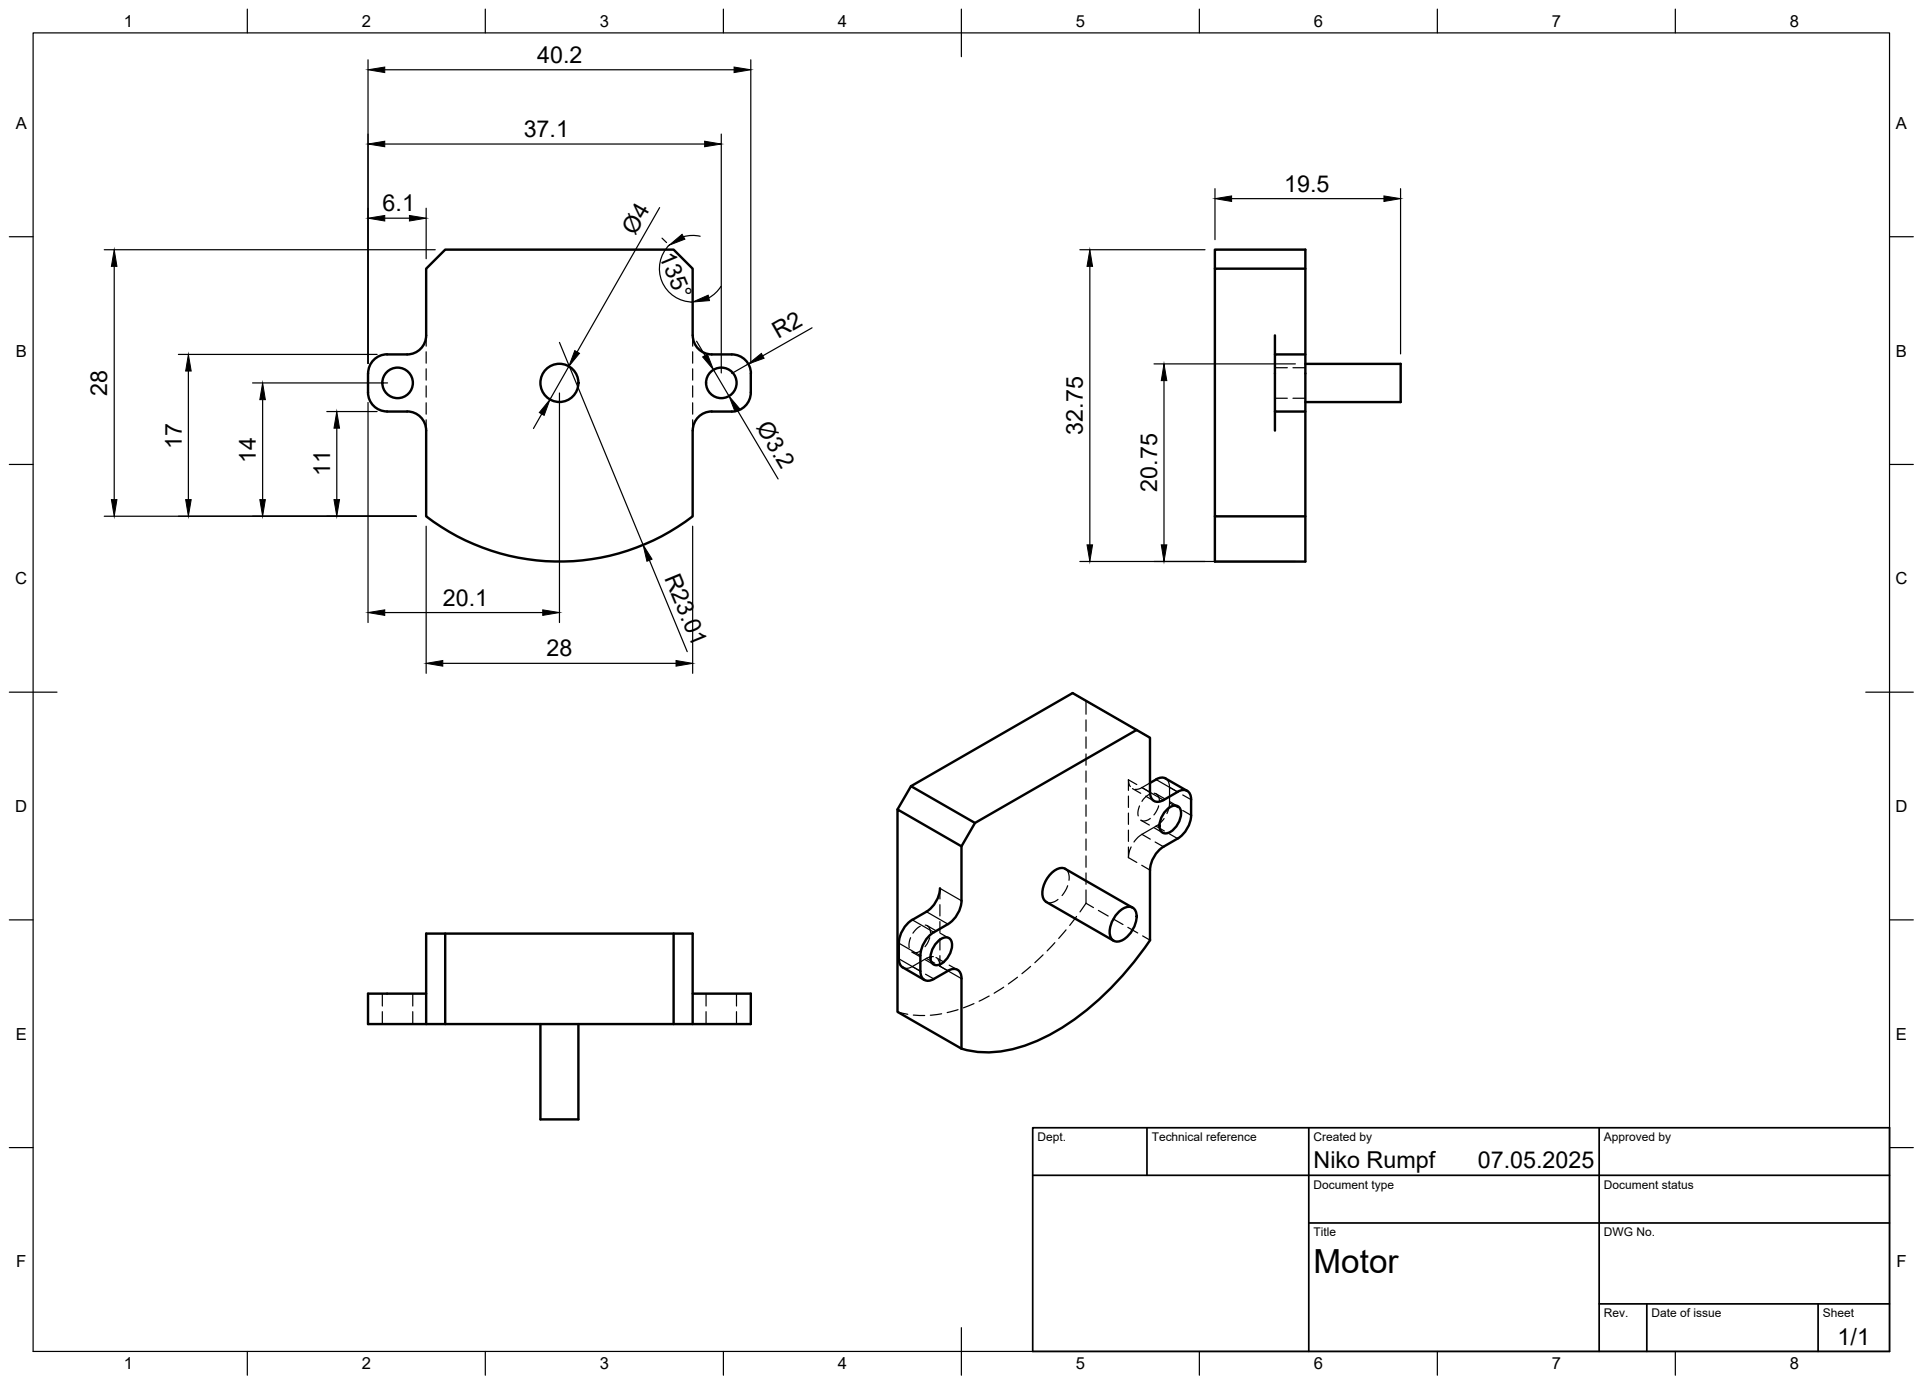
[picture p12: page 1]
Title; DWG No.; Rev.; Date of issue; Sheet

Dept. | Technical reference | Created by Niko Rumpf 07.05.2025 | Approved by

Document type | Document status
