FHW-Appel/MicroMouse-car/Technische Zeichnungen/Technische Zeichnung Display.pdf

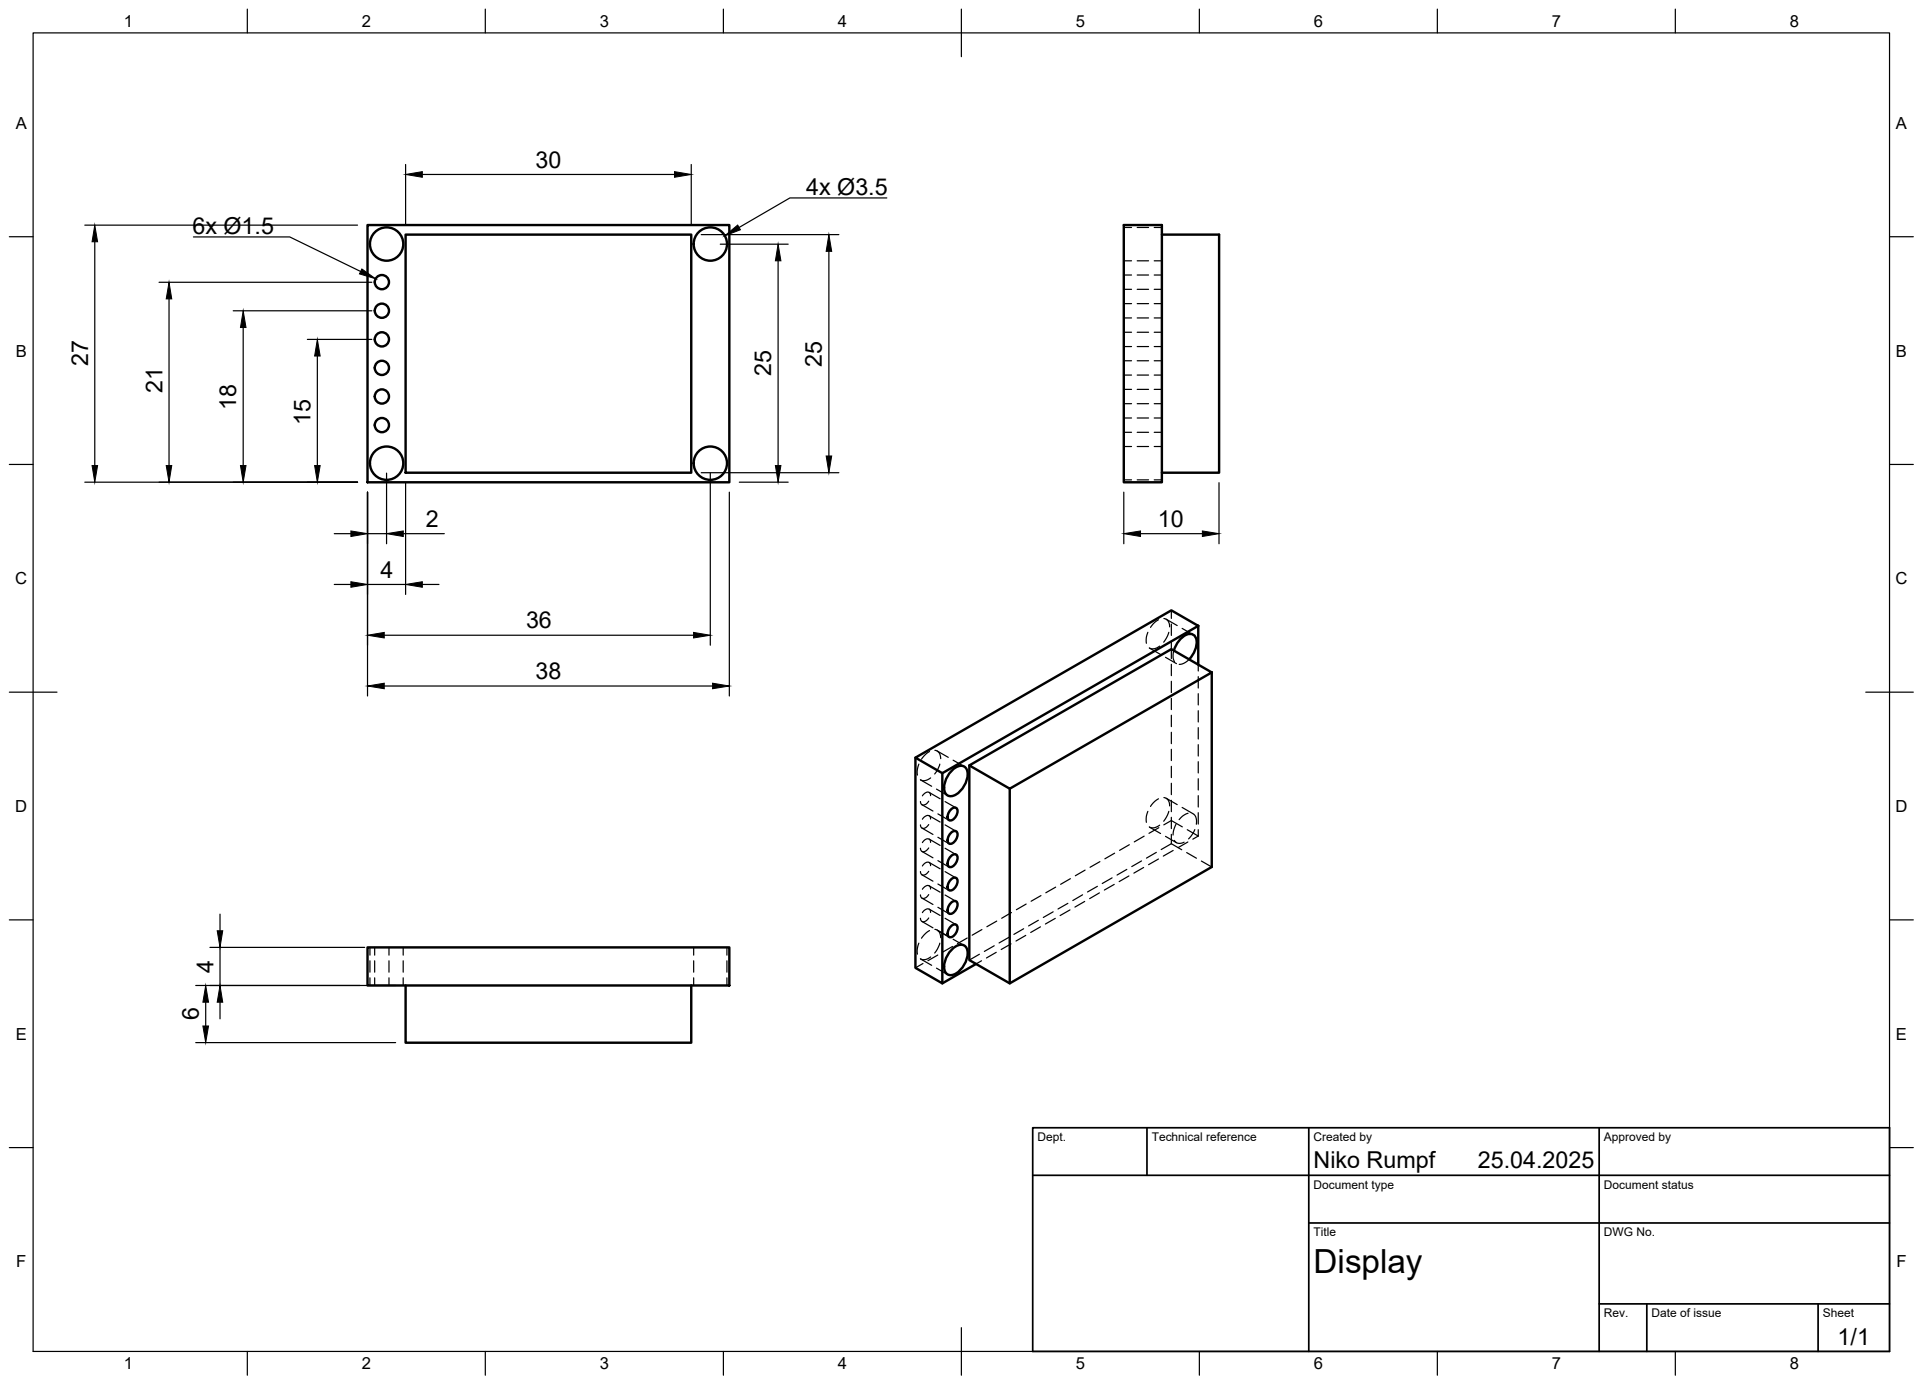
[picture p13: page 1]
Title; DWG No.; Rev.; Date of issue; Sheet

Dept. | Technical reference | Created by Niko Rumpf 25.04.2025 | Approved by

Document type | Document status
