FHW-Appel/MicroMouse-car/(commit log)

2025-04-23 1. Version der Micro Maus
2025-05-07 Technische Zeichnung Motor
2025-05-07 Rename Motor Zeichnung v1.pdf to Technische Zeichnung Motor.pdf
2025-05-16 Mirco Maus Prototyp V2.0
    Motorhalterung als Hauptbauteil der Maus.
    [Micro Maus Prototyp V2.0.f3z]
2025-06-06 Displaygehäuse V.1
    Displaygehäuse konstruiert von Luise Nißen.
    [Displaygehäuse.f3d]
2025-06-06 Schubplatte Displaygehäuse
    Schubplatte Displaygehäuse konstruiert von Luise Nißen.
    [SchubplatteDisplaygehäuse.f3d]
2025-06-06 Sensorhalterung u Schleifpunkt V.1.3
    Sensorhalterung u Schleifpunkt konstruiert von Thole und Niko
    [Sensorhalter_Schleifpunkt.f3d]
2025-06-06 Micro Maus Motorhalterung V1.5
    Micro Maus Motorhalterung
    [Micro Maus Motorhalterung.f3z]
2025-06-06 Reifen Grip V.5
    Reifen Grip konstruiert von Christoph Ernst
    [Reifen_Grip.f3d]
2025-06-13 Datei umbenannt zum Test
    [Reifennnnnn_Grip.f3d]
2025-06-13 V.1.8 Reifen
    Namensänderung zu GitHubdesktop test.
    [Reifen_Grip.f3d]
2025-06-13 V1.0 Akkuhalterung
    Erstellung der Akkuhalterung.
    Diese wird zwischen den Sensorhalterungen eingeklemmt.
    [Akkuhalterung v1.f3d]
2025-06-20 Unterordner "Fusion Konstruktionen" erstellen
    [Akkuhalterung v1.f3d, Displaygehäuse.f3d, Micro Maus Motorhalterung.f3z, Reifen_Grip.f3d, SchubplatteDisplaygehäuse.f3d, Sensorhalter_Schleifpunkt.f3d]
2025-06-27 Käse V.1.0
    Käse dient als Dekoration auf dem Deckel.
    [Kaese v1.f3d]
2025-06-27 Käse V.1.0
    Käse als Deko mit LED.
    [Kaese.f3d]
2025-06-27 Akkuhalterung V.1.0
    [Akkuhalterung.f3d]
2025-06-27 Platinengehäuse V.1.5
    [Platinengehäuse.f3d]
2025-06-27 Deckel V.1.2
    [Deckel.f3d]
2025-06-27 Sensorhalterung u. Schleifpunkt V.1.8
    [Sensorhalter_Schleifpunkt.f3d]
2025-06-27 Hinzufügen der STL Dateien
    [Akkuhalterung.stl, Deckel.stl, Displaygehäuse.stl, Kaese.stl, Reifen_Grip.stl, Schubplatte_Display.stl, Sensorhalter_Schleifpunkt.stl]
2025-06-27 Technische Zeichnungen haben wir zunächst weggelassen
2025-06-27 Motorhalterung V.1.12
    [Motorhalterung.stl]
